Xwyk/fluo/rapports/TDB1.odt

Dpt INFO – Tableau de bord – STAGE 2017

| Lundi | Mardi | Mercredi | Jeudi | Vendredi | Bilan
Objectifs | - Poser le problème - veille techno - Lister le matériel | - Achat du matériel - réflexion sur l’IHM | | Étude de la documentation | Projet bien avancé après cette première semaine
Outils utilisés | Internet | internet | | Doc technique/Internet | Documentation papier et numérique
Documentation | Doc technique des composants | non
Contacts | Courts entretiens quotidiens avec le maître de stage (2-3)
Résultats | - Matériel listé - veille techno - ébauche de code pour récupérer le signal des capteurs | Après discussion, orientation vers une appli Web plutôt que C++ | | Compréhension de certains mécanismes de la machine
Difficultés | Tension des capteurs non compatible avec le microcontrôleur | Revendeur électronique vannetais fermé | | Documentation longue et rédigée en anglais | Quelques difficultés qui retardent l’avancement
Initiatives | Toutes les décisions prises, puisque je suis mon équipe
Acquis | | Fonctionnement de circuits intégrés | | - principe de communication en RS232 - Réglage de la machine
Commentaires
