Xwyk/fluo/(commit log)

2017-04-10 Ajout des premiers fichiers (code et premier rapport)
2017-04-10 Organisation plus méthodique des documents
2017-05-02 Ajout de toute la partie web
2017-05-02 Ajout des rapports
2017-05-05 ménage dans les ressources communication arduino-appli web fonctionnelle contrôleurs fonctionnels
